gcronin/ISP-AVRchips/DSCF0001.JPG

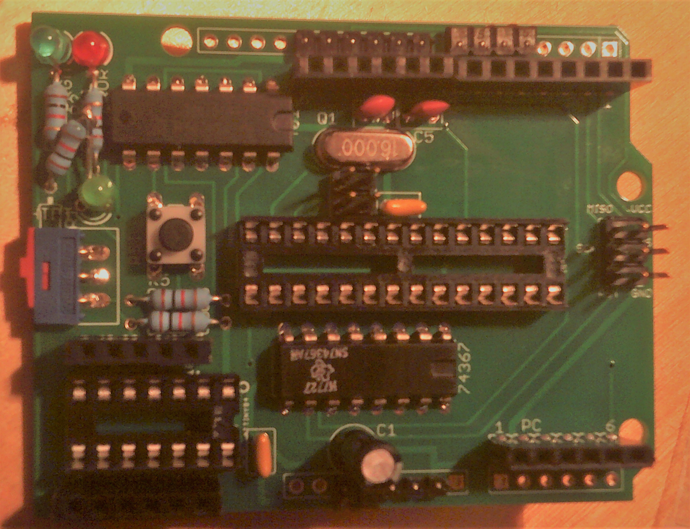
DSCF0001.JPG
