gcronin/ISP-AVRchips/DSCF0005.JPG

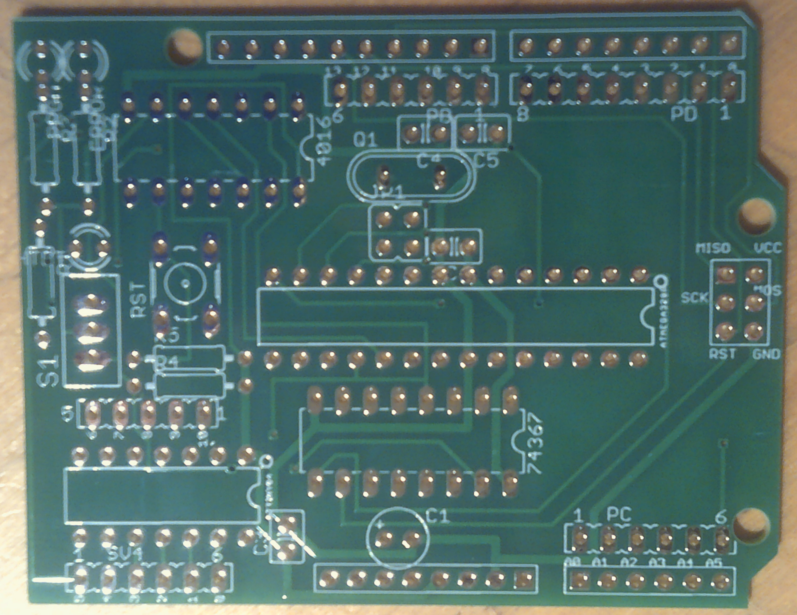
DSCF0005.JPG
