gcronin/ISP-AVRchips/DSCF0002 (2).JPG

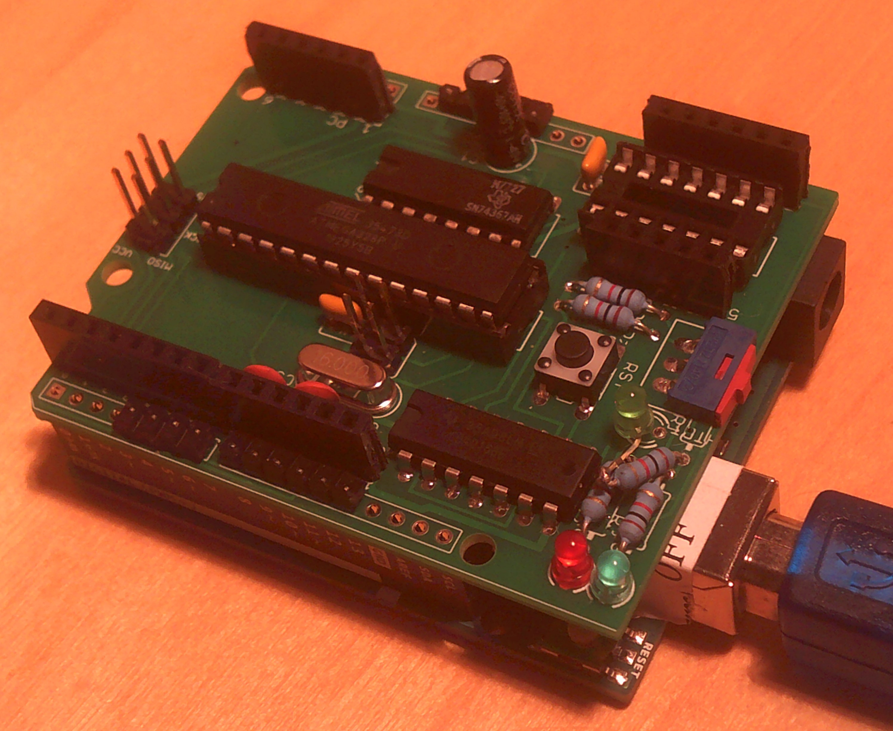
DSCF0002 (2).JPG
