gcronin/ISP-AVRchips/DSCF0002.JPG

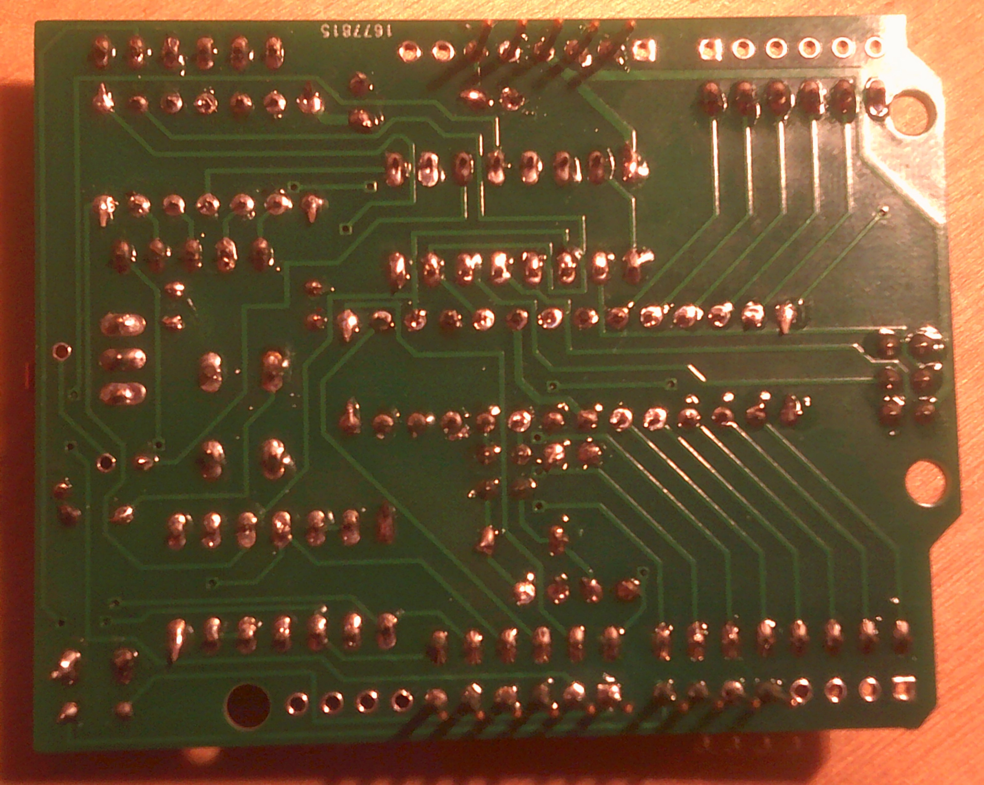
DSCF0002.JPG
