gcronin/ISP-AVRchips/DSCF0003.JPG

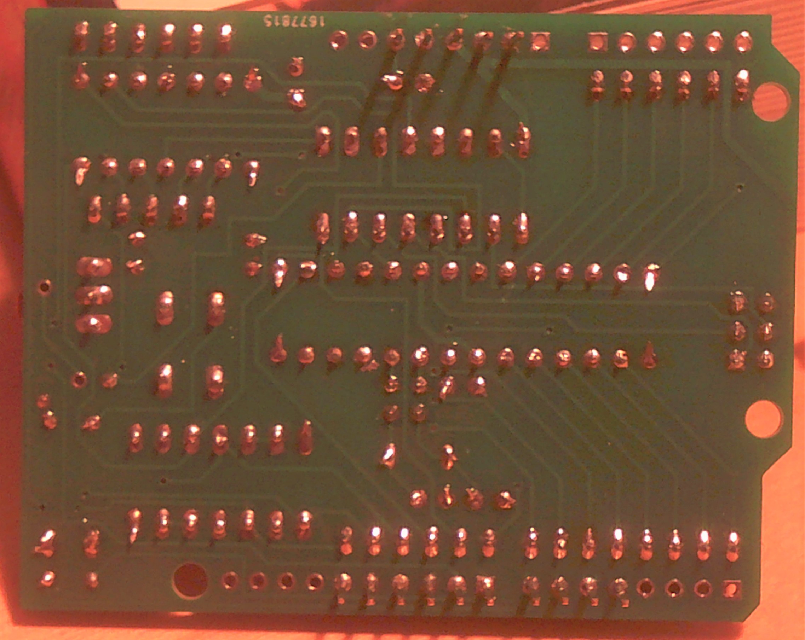
DSCF0003.JPG
