gcronin/ISP-AVRchips/DSCF0004.JPG

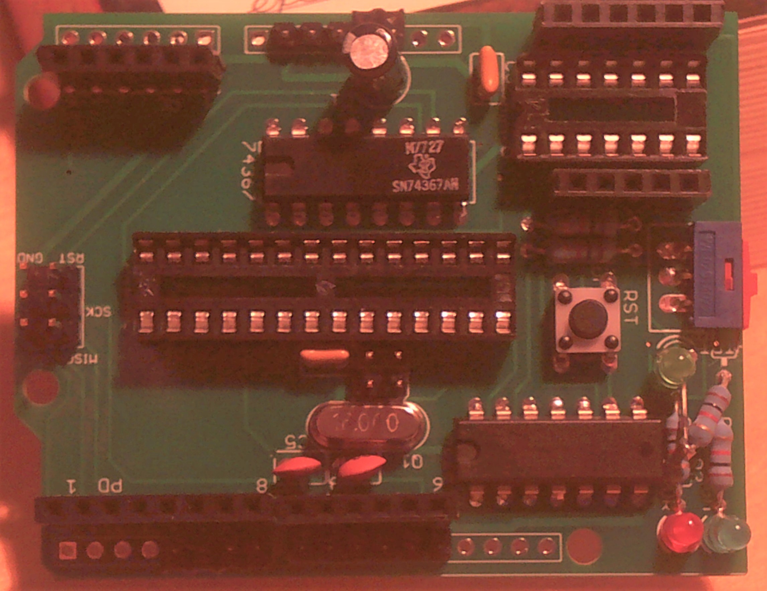
DSCF0004.JPG
