gcronin/ISP-AVRchips/DSCF0006.JPG

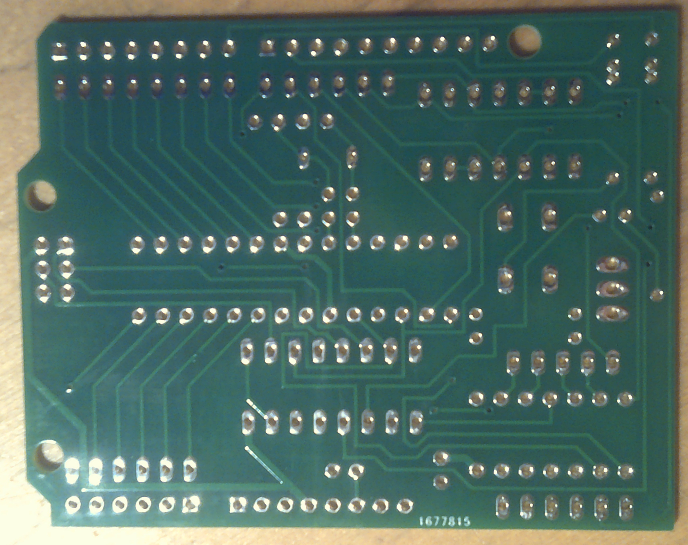
DSCF0006.JPG
