gcronin/ISP-AVRchips/ISP_Arduino_Board.brd

## EAGLE design ISP_Arduino_Board.brd (2022-03-14)

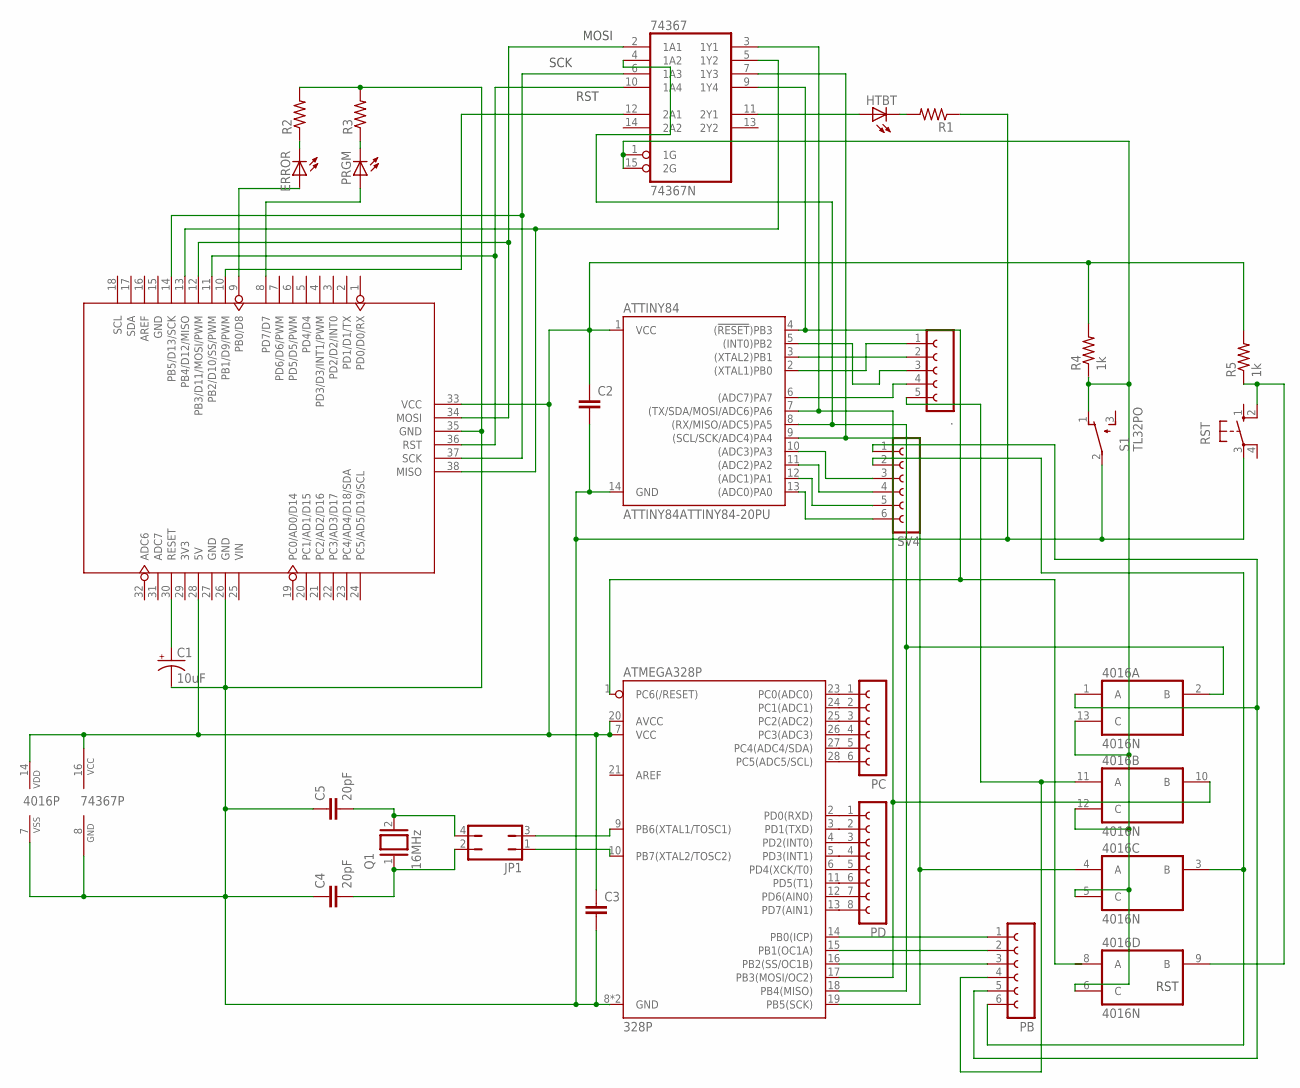
[picture p18: schematic ISP_Arduino_Board.sch]

Parts:
4016: 4016N; DIL14
74367: 74367N; DIL16
.: FE05-1
ATMEGA328P: 328P; DIP28
ATTINY84: ATTINY84ATTINY84-20PU; DIP14
C1: 10uF; E2,5-6
C2, C3: C2,5-3; C2.5-3
C4, C5: 20pF; C2.5-3
ERROR: LED3MM
HTBT: LED3MM
JP1: JP2Q
PB: FE06-1; FE06
PC: FE06-1; FE06
PD: FE08-1; FE08
PRGM: LED3MM
Q1: 16MHz; QS
R1, R2, R3: R-US_0207/10; 0207/10
R4, R5: 1k; 0207/10
RST: 10-XX; B3F-10XX
S1: TL32PO; TL3XPO
SV4: FE06-1; FE06
U2: DIP Long Blue Female Header; ARDUINO-38P

Connections:
GND: 4016.7 (VSS), 74367.8 (GND), ATMEGA328P.8 (GND), ATMEGA328P.22 (GND), ATTINY84.14 (GND), C1.-, C2.2, C3.2, C4.1, C5.1, R1.1, R2.2, R3.2, RST.3, S1.2, U2.26 (GND), U2.35 (GND)
unnamed: 4016.14 (VDD), 74367.16 (VCC), ATMEGA328P.7 (VCC), ATMEGA328P.20 (AVCC), ATTINY84.1 (VCC), C2.1, C3.1, R4.2, R5.2, U2.28 (5V), U2.33 (VCC)
unnamed: 4016.11 (A), ..5, PB.4
unnamed: 4016.4 (A), 74367.7 (1Y3), ATMEGA328P.19 (PB5(SCK)), ATTINY84.9 ((SCL/SCK/ADC4)PA4)
unnamed: C1.+, U2.30 (RESET)
unnamed: 4016.2 (B), 74367.4 (1A2), ATMEGA328P.18 (PB4(MISO)), ATTINY84.8 ((RX/MISO/ADC5)PA5)
unnamed: ATMEGA328P.14 (PB0(ICP)), PB.1
unnamed: PRGM.K (C), R3.1
unnamed: C5.2, JP1.4, Q1.2
unnamed: ERROR.K (C), R2.1
unnamed: HTBT.K (C), R1.2
unnamed: 74367.12 (2A1), U2.10 (PB1/D9/PWM)
unnamed: 74367.2 (1A1), U2.12 (PB3/D11/MOSI/PWM), U2.34 (MOSI)
unnamed: PRGM.A, U2.8 (PD7/D7)
unnamed: 74367.9 (1Y4), ATMEGA328P.1 (PC6(/RESET)), ATTINY84.4 ((!RESET!)PB3)
unnamed: C4.2, JP1.2, Q1.1
unnamed: ATMEGA328P.9 (PB6(XTAL1/TOSC1)), JP1.3
unnamed: ATMEGA328P.10 (PB7(XTAL2/TOSC2)), JP1.1
unnamed: ERROR.A, U2.9 (PB0/D8)
unnamed: 74367.10 (1A4), U2.11 (PB2/D10/SS/PWM), U2.36 (RST)
unnamed: 74367.5 (1Y2), U2.13 (PB4/D12/MISO), U2.38 (MISO)
unnamed: 74367.6 (1A3), U2.14 (PB5/D13/SCK), U2.37 (SCK)
unnamed: ATMEGA328P.2 (PD0(RXD)), PD.1
unnamed: ATMEGA328P.3 (PD1(TXD)), PD.2
unnamed: 4016.5 (C), 4016.6 (C), 4016.12 (C), 4016.13 (C), 74367.1 (1G), 74367.15 (2G), R4.1, S1.1 (O)
unnamed: ATMEGA328P.23 (PC0(ADC0)), PC.1
unnamed: ATMEGA328P.24 (PC1(ADC1)), PC.2
unnamed: ATMEGA328P.25 (PC2(ADC2)), PC.3
unnamed: ATMEGA328P.26 (PC3(ADC3)), PC.4
unnamed: ATMEGA328P.27 (PC4(ADC4/SDA)), PC.5
unnamed: ATMEGA328P.28 (PC5(ADC5/SCL)), PC.6
unnamed: ATMEGA328P.4 (PD2(INT0)), PD.3
unnamed: ATMEGA328P.5 (PD3(INT1)), PD.4
unnamed: ATMEGA328P.6 (PD4(XCK/T0)), PD.5
unnamed: ATMEGA328P.11 (PD5(T1)), PD.6
unnamed: ATMEGA328P.12 (PD6(AIN0)), PD.7
unnamed: ATMEGA328P.13 (PD7(AIN1)), PD.8
unnamed: ATMEGA328P.15 (PB1(OC1A)), PB.2
unnamed: ATMEGA328P.16 (PB2(SS/OC1B)), PB.3
unnamed: 4016.3 (B), PB.6, SV4.2
unnamed: 4016.1 (A), PB.5, SV4.1
unnamed: 4016.9 (B), R5.1, RST.2 (S1)
unnamed: 74367.11 (2Y1), HTBT.A
unnamed: ..1, ATTINY84.2 ((XTAL1)PB0)
unnamed: ..2, ATTINY84.3 ((XTAL2)PB1)
unnamed: ..3, ATTINY84.5 ((INT0)PB2)
unnamed: ..4, ATTINY84.6 ((ADC7)PA7)
unnamed: ATTINY84.13 ((ADC0)PA0), SV4.6
unnamed: ATTINY84.12 ((ADC1)PA1), SV4.5
unnamed: ATTINY84.11 ((ADC2)PA2), SV4.4
unnamed: ATTINY84.10 ((ADC3)PA3), SV4.3
PD: 4016.10 (B), 74367.3 (1Y1), ATMEGA328P.17 (PB3(MOSI/OC2)), ATTINY84.7 ((TX/SDA/MOSI/ADC6)PA6)

Notes on the sheet:
SCK
MOSI
RST

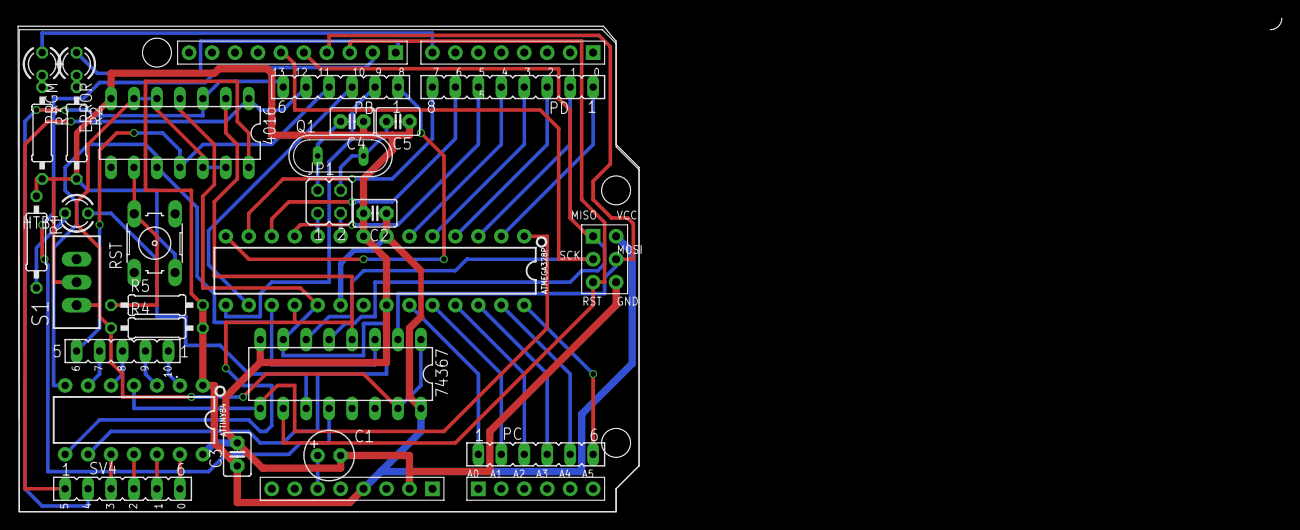
[picture p19: board ISP_Arduino_Board.brd from above]

Board: 2 copper layers, 68.7 x 53.7 mm, 27 parts (0 on the bottom side), 52 nets.
